esch3r/IRemote/README.md

IRemote
=======

A simple IR sniffer, writer base on an ARM µC
