esch3r/IRemote/13010009.jpg

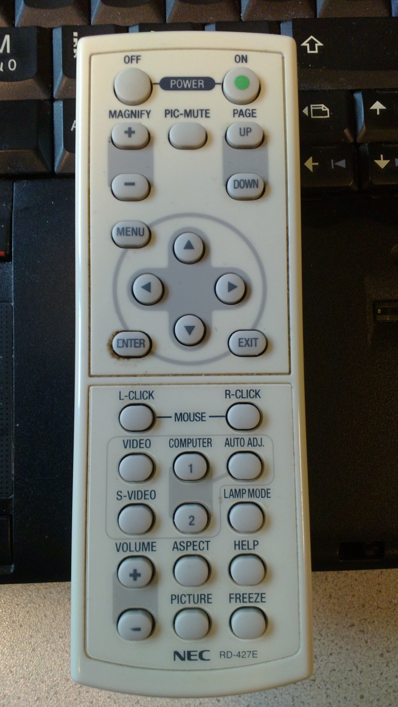
13010009.jpg
