esch3r/IRemote/13010057.jpg

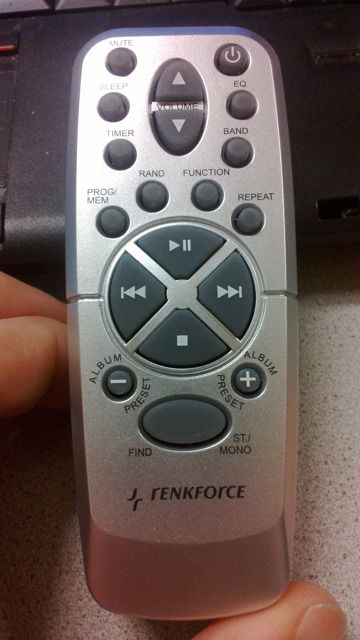
13010057.jpg
