esch3r/IRemote/other/Wiring.ods

IRemote Peripheral Wiring:
Name | EStick 2 | PORT/PIN | Peripheral | PORT/PIN
WiFly UART-TX | TXD_BB | X4/9 | WiFly RN-XV | DIN
WiFly UART-RX | RXD_BB | X4/10 | WiFly RN-XV | DOUT
PWM-Out | TOUT/OLED_CS# | X4/8 | FET/Diode
IR-In | ACCEL_INT2/TX_ENABLE | X4/22 | TSOP4838 | OUT
SPI-SCK1 | P0_7/SCK | X4/7 | RFM12B 433MHz | SCK
SPI-MISO1 | P0_8/MISO | X4/6 | RFM12B 433MHz | FFIT/SDO
SPI-MOSI1 | P0_9/MOSI | X4/5 | RFM12B 433MHz | SDI
ISM-In | P2_2/GPIO | X4/14 | RFM12B 433MHz | FSK/DATA/nFFS
SPI-SEL0 | P0_25/ADC02 | X4/15 | RFM12B 433MHz | nSEL
SPI-SCK1 | P0_7/SCK | X4/7 | RFM12B 836MHz | SCK
SPI-MISO1 | P0_8/MISO | X4/6 | RFM12B 836MHz | FFIT/SDO
SPI-MOSI1 | P0_9/MOSI | X4/5 | RFM12B 836MHz | SDI
836-In | P0_22/RTS1 | X4/21 | RFM12B 836MHz | FSK/DATA/nFFS
SPI-SEL1 | P0_26/GPIO/AD03 | X4/20 | RFM12B 836MHz | nSEL
LED 0 | P1_29 | ONBOARD | LED 0
LED 1 | P0_0/SDA1 | X3/13 | GREEN LED
LED 2 | P0_1/SCL1 | X3/14 | YELLOW LED
LED 3 | P0_10/MAT30/GPIO | X3/15 | RED LED
BUTTON 0 | P2_4/GPIO | X3/19 | BUTTON 0
BUTTON 1 | P2_5/GPIO | X3/20 | BUTTON 1
BUTTON 2 | P2_10/Ext. Int | X3/21 | BUTTON 2
