esch3r/IRemote/manuals/BD189.pdf

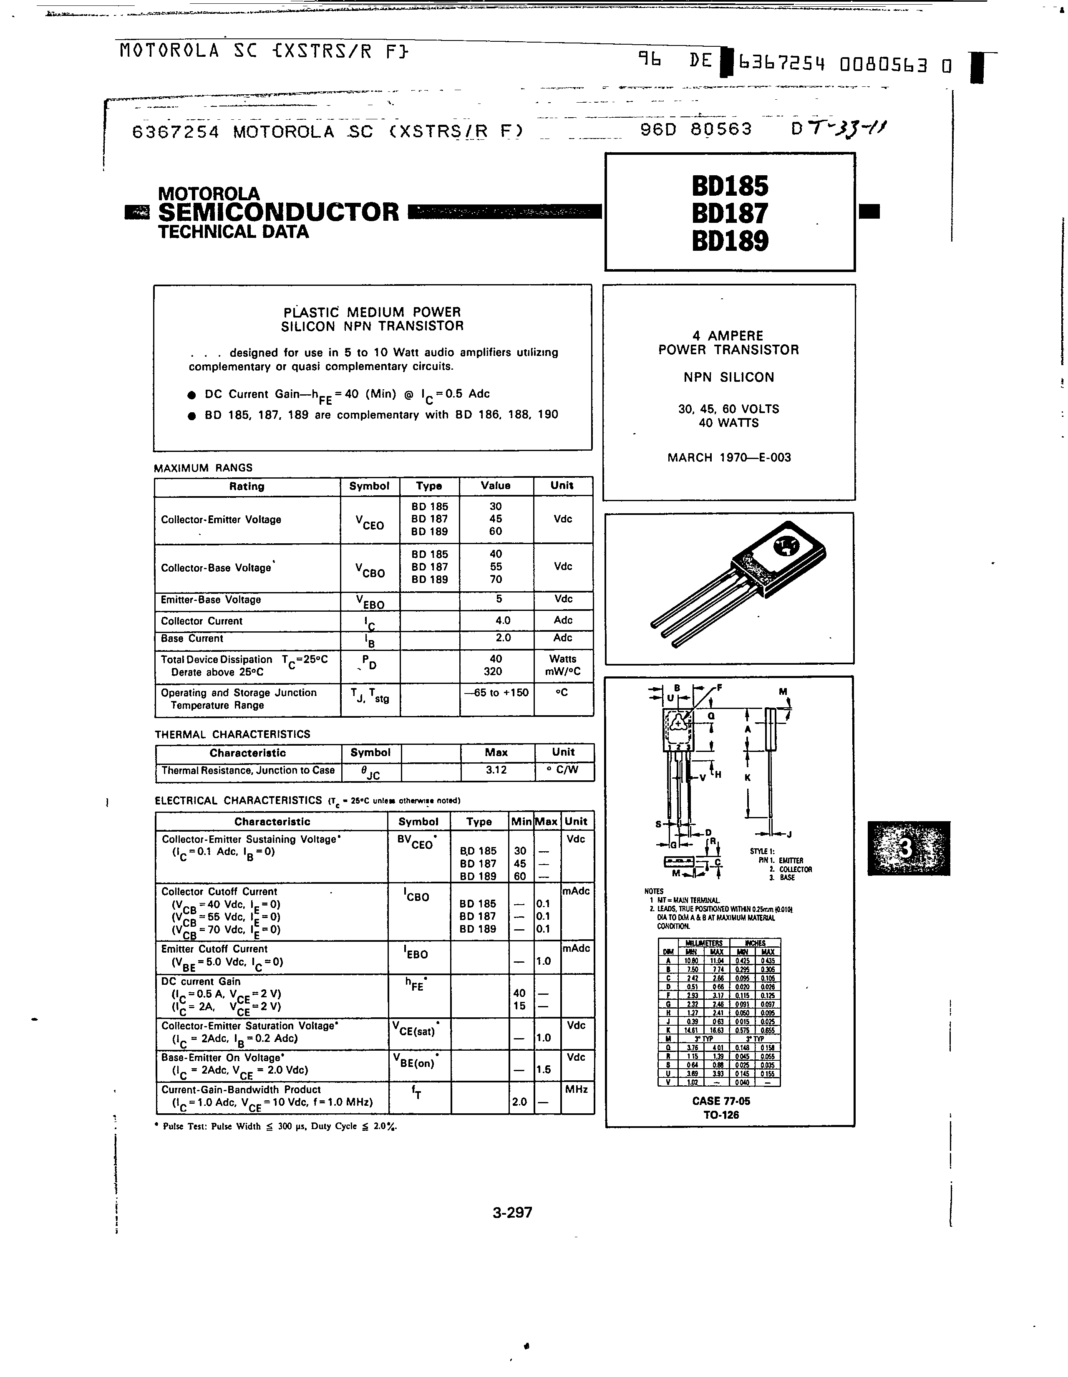
[picture p5: page 1]
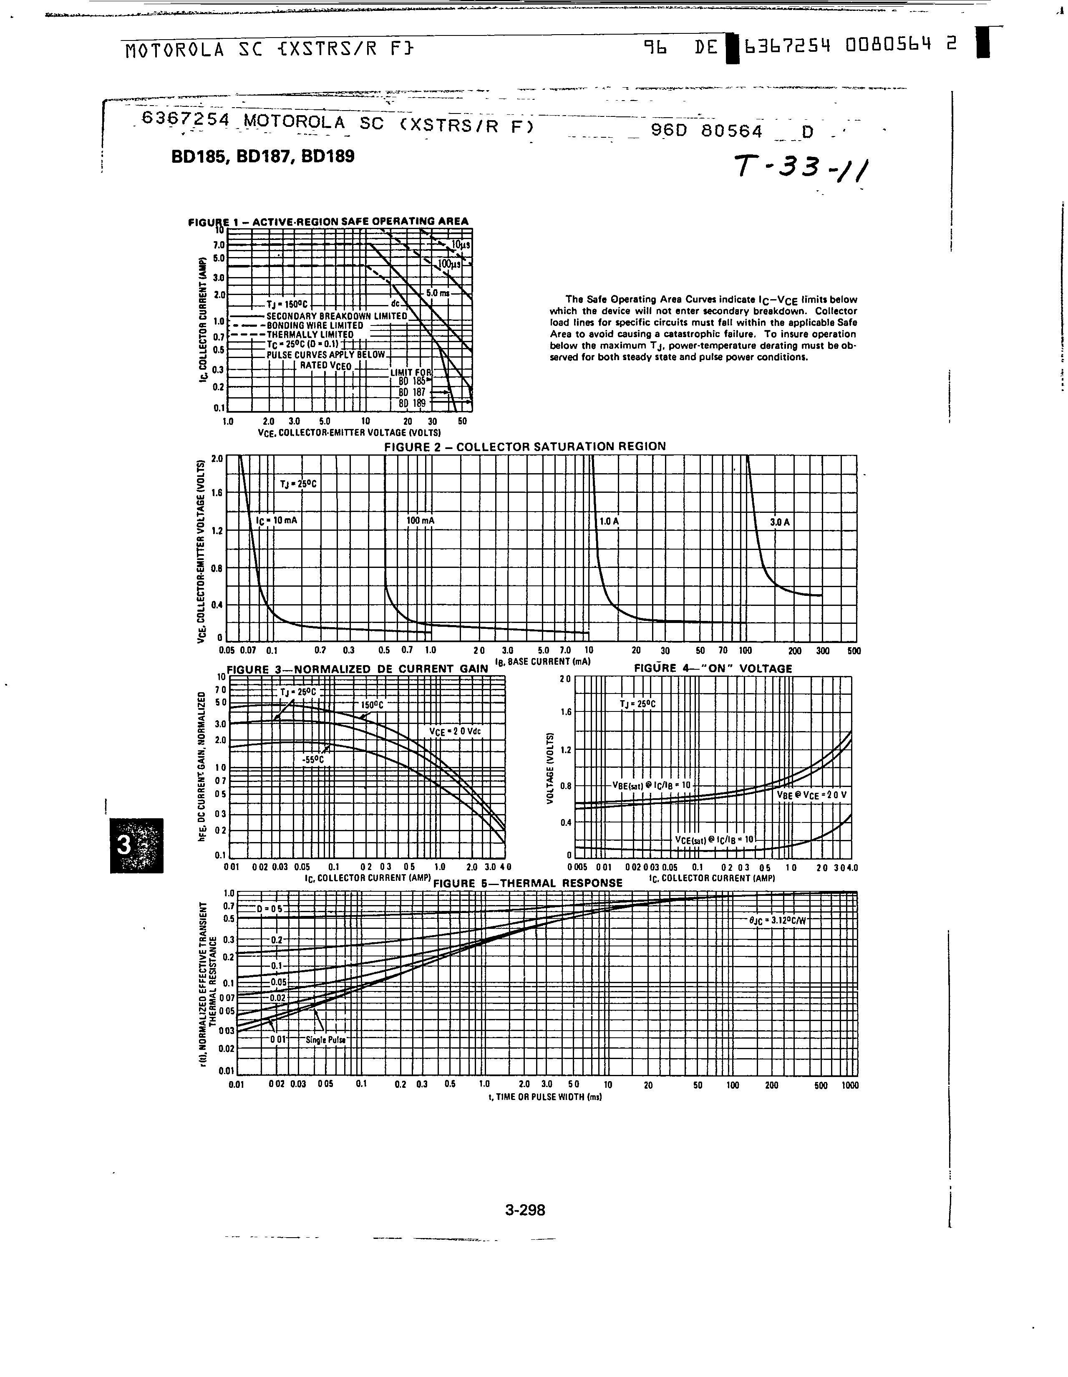
[picture p6: page 2]
