esch3r/IRemote/spice/projekt_mosfet.asc

M1: nmos; IRLML2803
R1: res; 100K; tol=1 pwr=0.1
R2: res; 100
V1: 3.3
V2: PULSE(0 3.3 300µ 1µ 1µ 300µ 600µ)
Named nets: 0
.tran 0 2m 0 1µ
