esch3r/IRemote/code/iremote.h

/**
 * @file iremote.h
 * @author Alexander Rössler
 * @brief IRemote specific functions
 * @date 4-01-2012
 */

#pragma once

#define PRINTF_BUFFER_SIZE  420

#include <wifly.h>
#include <uart.h>
#include <led.h>
#include <timer.h>
#include <stdarg.h>
#include <stdio.h>
#include <led.h>
#include <iap.h>
#include <timeout.h>
#include <button.h>
#include <pwm.h>
#include <crc.h>
#include "remotecontrol.h"

typedef enum {
    ApplicationState_Idle = 0,
    ApplicationState_CaptureIrCommand = 1,
    ApplicationState_CaptureRadio433MhzCommand = 4,
    ApplicationState_CaptureRadio868MhzCommand = 5,
    ApplicationState_RunCommand = 2,
    ApplicationState_FlashFirmware = 3,
    ApplicationState_WiFlyTest = 100
} ApplicationState;

typedef enum {
    NetworkMode_Adhoc = 0,
    NetworkMode_Infrastructure = 1,
    NetworkMode_None = 2
} NetworkMode;

typedef enum {
        SerialConnection = 0x01,
        NetworkConnection = 0x02
    } ActiveConnection;

typedef struct {
    uint8  firstStartIdentificator; // if this is not 42 then we have a first start
    uint32 irReceiveTimeout;
    uint32 irSendTimeout;
    uint32 irRepeatCount;
    uint32 radio433ReceiveTimeout;
    uint32 radio433SendTimeout;
    uint32 radio433RepeatCount;
    uint32 radio868ReceiveTimeout;
    uint32 radio868SendTimeout;
    uint32 radio868RepeatCount;
    char   wlanSsid[100];
    char   wlanPhrase[100];
    char   wlanKey[100];
    char   wlanHostname[100];
    uint8  wlanAuth;
    uint8  wlanDhcp;
    char   wlanIp[20];
    char   wlanMask[20];
    char   wlanGateway[20];
    uint8  networkMode;
    char   wlanPrimaryDnsAddress[20];
    char   wlanSecondaryDnsAddress[20];
} ApplicationSettings;

typedef enum {
    LedOnBoard = Led0,
    LedGreen = Led1,
    LedYellow = Led2,
    LedRed = Led3
} ApplicationLed;

int8 initializeHardware(void);
int8 initializeVariables(void);
int8 initializeSerialConnection(void);
int8 initializeNetworkConnection(void);

int8 startWlanInfrastructureMode(ApplicationSettings *settings);
int8 startWlanAdhocMode(void);
    
int8 printfData(char* format, ...);
int8 putcharData(char c);
int8 writeData(void *data, uint32 length);

void errorCommand();
void errorWiFly();
void printUnknownCommand(void);
void printParameterMissing(void);
void printAcknowledgement(void);
void printError(char *message);
void printAliveMessage(void);
bool compareBaseCommand(char *original, char *received);
bool compareExtendedCommand(char *original, char *received);
void processCommand(char *buffer);

void startState(ApplicationState state);

void mainTask(void);
void ledTask(void);
void buttonTask(void);

uint32 hex2int(char *a, unsigned int len);
