esch3r/IRemote/(commit log)

2012-12-05 added code
    [LPC1758_OOCD_CMARM.cfg, LPC1758_OOCD_CMARM_run.cfg]
2012-12-08 pwm.h und pwm.c erstellt und befüllt, pwm.h wird noch in lib und driver file aufgesplittet.
2012-12-08 Makefile nix geändert
    [LPC1758_OOCD_CMARM.cfg]
2012-12-09 fixed build and pwm
    [LPC1758_OOCD_CMARM.cfg]
2012-12-23 added button files
2012-12-23 added a lot og stuff
    [Wiring.ods]
2013-01-02 Button files splitted
2013-01-02 implemented wifly functions, added uart functionality
2013-01-03 imroved and fixed a bit
    [Wiring.ods]
2013-01-07 wireless works now
2013-01-10 corrected button and pwm files sdfasdfasfsaf
    [RFM12_receive.c, RFM12_transmit.c]
2013-01-10 corrected button and pwm files
    d buttn and pwm filesease enter the commit message for your changes. Lines starting
    [main.c]
2013-01-10 nothing done
    [LPC1758_OOCD_CMARM.cfg]
2013-01-23 spi and sspi files added
    [Wiring.ods]
2013-01-24 changed leds improved desktop
    [Wiring.ods]
2013-01-26 button-lib with typy low or highactive added
2013-01-27 led functionality improved
2013-01-27 changes by button lib
2013-01-28 removed lpc libraries made buttons working Please enter the commit message for your changes. Lines starting
2013-01-28 ssp0 without compile errors Bitte gebe eine Versionsbeschreibung für deine Änderungen ein. Zeilen,
    [main.c]
2013-01-29 switched all function out of the main
2013-01-29 added pwm driver
2013-01-29 ssp0 init repaired
    [Wiring.ods]
2013-01-29 addes this and that fixed something
    [iremote.c, iremote.h]
2013-01-30 fixing fixing fixing
    [housing.scad]
2013-02-09 ssp is now working
    [Wiring.ods, housing.scad]
2013-02-10 improved the timer library improved the ssp library
2013-02-18 made rfm12 working added comments for ssp changed wiring
    [Wiring.ods]
2013-02-19 fixed timer improved rfm12
    [iremote.c]
2013-02-22 just wireing changed
    [Wiring.ods]
2013-03-01 Renaming in uart and wifly
2013-03-04 improved gui fixed a few bugs
    [iremote.c, iremote.cpp, iremote.h, iremotewindow.cpp, iremotewindow.h]
2013-03-09 reconfigured the interface and added missing things not finished yet
    [iremote.c, iremote.cpp, iremote.h, iremotewindow.cpp, iremotewindow.h, remotecommand.c, remotecommand.h, remotecontrol.c]
